iperrin/EspressoMachine/HeaterDutyCycleTesting.xlsx

Sheet: Sheet1
Temperature | Duty Cycle
53 | 0.05
54 | 0.1
60 | 0.15
74 | 0.2
82.5 | 0.22
88 | 0.25
93.6 | 0.3
97 | 0.35
98.5 | 0.4
99.3 | 0.45
99.5 | 0.5

Sheet: pChip Interpolation
53 | 0.05
53.1 | 0.05577722482
53.2 | 0.06181108509
53.3 | 0.06794057377
53.4 | 0.07400468384
53.5 | 0.07984240827
53.6 | 0.08529274005
53.7 | 0.09019467213
53.8 | 0.0943871975
53.9 | 0.09770930913
54 | 0.1
54.1 | 0.1016969602
54.2 | 0.1033458653
54.3 | 0.1049476867
54.4 | 0.1065033958
54.5 | 0.108013964
54.6 | 0.1094803625
54.7 | 0.1109035628
54.8 | 0.1122845361
54.9 | 0.1136242539
55 | 0.1149236875
55.1 | 0.1161838083
55.2 | 0.1174055876
55.3 | 0.1185899968
55.4 | 0.1197380072
55.5 | 0.1208505902
55.6 | 0.1219287172
55.7 | 0.1229733594
55.8 | 0.1239854883
55.9 | 0.1249660753
56 | 0.1259160916
56.1 | 0.1268365086
56.2 | 0.1277282977
56.3 | 0.1285924303
56.4 | 0.1294298776
56.5 | 0.1302416111
56.6 | 0.1310286022
56.7 | 0.131791822
56.8 | 0.1325322421
56.9 | 0.1332508338
57 | 0.1339485685
57.1 | 0.1346264174
57.2 | 0.1352853519
57.3 | 0.1359263435
57.4 | 0.1365503634
57.5 | 0.1371583831
57.6 | 0.1377513738
57.7 | 0.138330307
57.8 | 0.1388961539
57.9 | 0.139449886
58 | 0.1399924746
58.1 | 0.140524891
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
