iperrin/EspressoMachine/(commit log)

2022-01-29 Adding thermal data collection file
    [HeaterDutyCycleTesting.xlsx]
2022-03-06 switch to vertical
2022-03-25 timer update
2022-04-12 update after PCB install
2022-04-15 stayHot button
2022-04-15 stochastic heating
2022-04-29 resolved autosequence timer
2022-04-29 timer fix
2022-04-30 updated filtering on other sensors
2022-04-30 restructure files
    [HeaterDutyCycleTesting.xlsx, ZeroFlowPumpData.xlsx]
2022-05-03 adding flow rates
2022-05-04 implemented flowrate calculations and additional filters
2022-05-25 flow lock
2022-05-27 update flow PID values
2022-05-27 updated flow delay
2022-05-27 changed flowlock to flowlimit
2022-07-10 updated flow - more accurate values and updated flow lock preset
2023-09-10 updating arduino and gui to show heater settings
2023-09-17 adding steam wand valve functionality
